hansimb/pedal-controller-prototype/docs/part2/setup.jpg

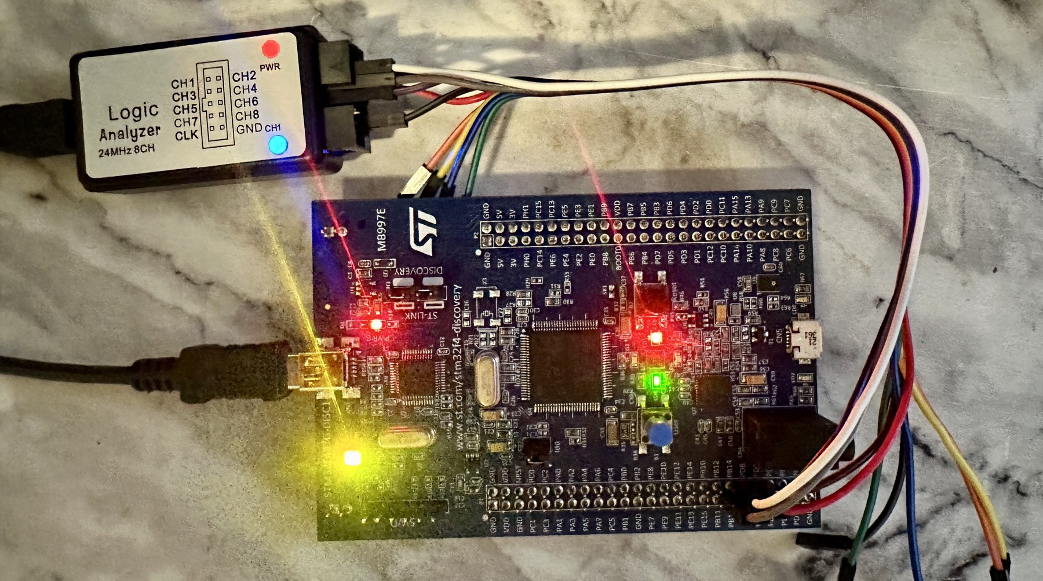
docs/part2/setup.jpg
