hansimb/pedal-controller-prototype/docs/part2/leds_p1.jpg

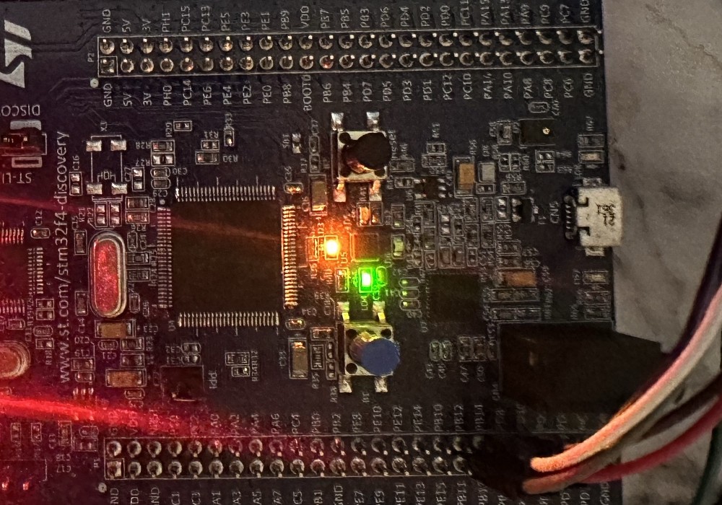
docs/part2/leds_p1.jpg
