hansimb/pedal-controller-prototype/docs/part2/leds_live.jpg

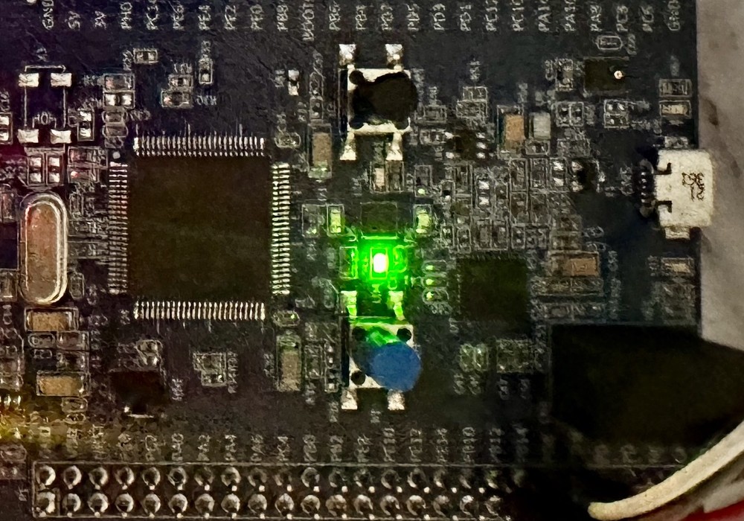
docs/part2/leds_live.jpg
