hansimb/pedal-controller-prototype/docs/part2/leds_p2.jpg

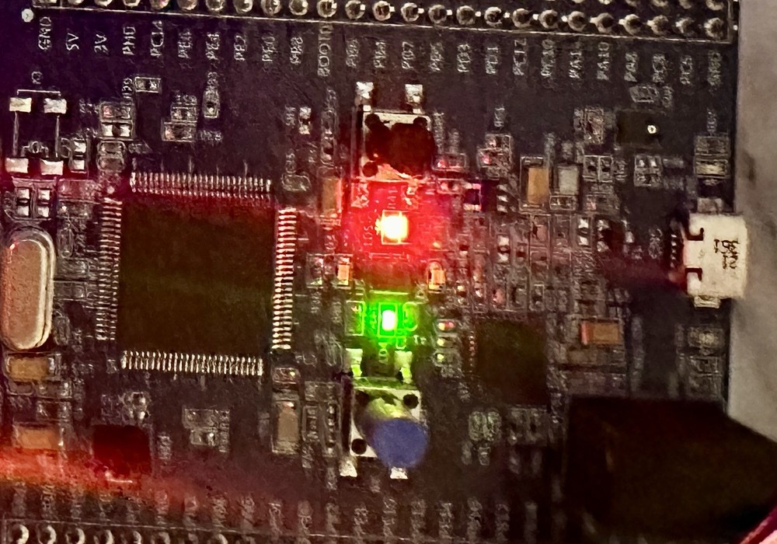
docs/part2/leds_p2.jpg
