hansimb/pedal-controller-prototype/docs/part2/leds_standby.jpg

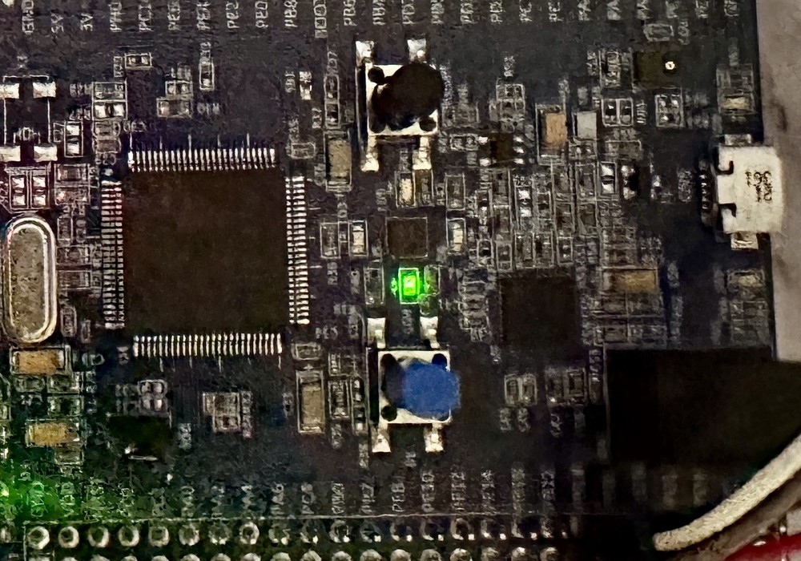
docs/part2/leds_standby.jpg
