hansimb/pedal-controller-prototype/docs/part2/spi_live.png

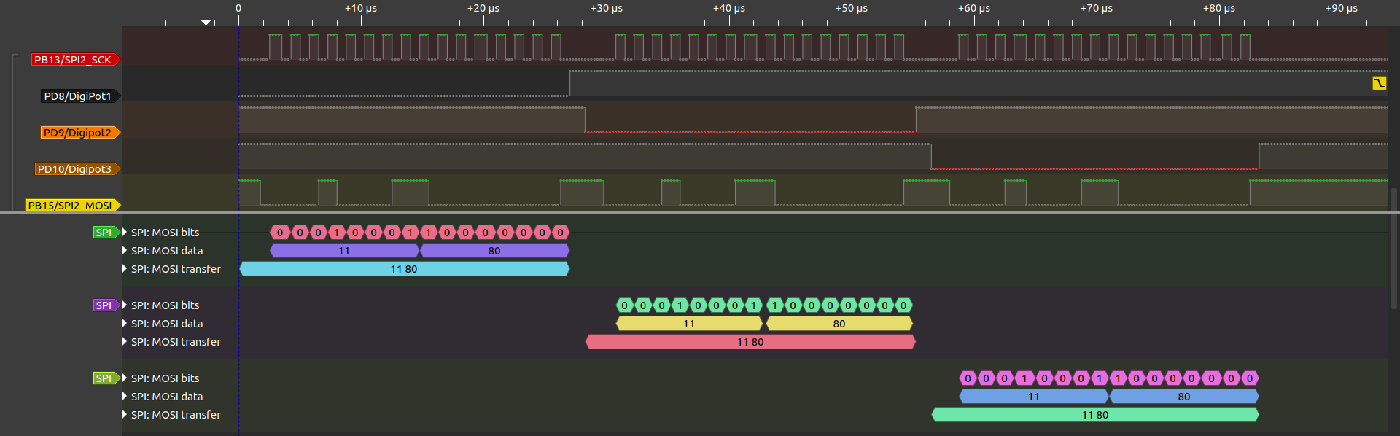
docs/part2/spi_live.png
