hansimb/pedal-controller-prototype/docs/part2/spi_p1.png

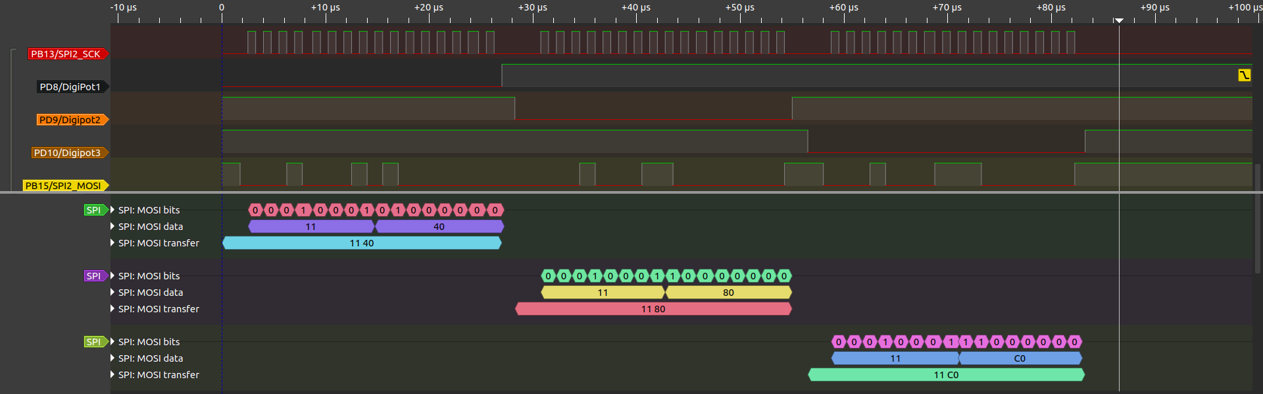
docs/part2/spi_p1.png
