hansimb/pedal-controller-prototype/docs/part2/spi_p2.png

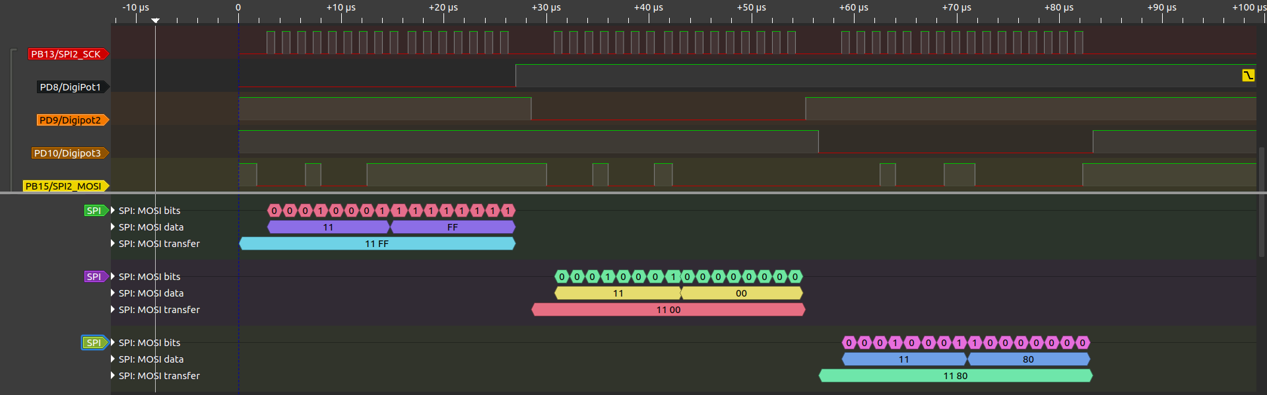
docs/part2/spi_p2.png
