hansimb/pedal-controller-prototype/docs/part2/spi_standby.png

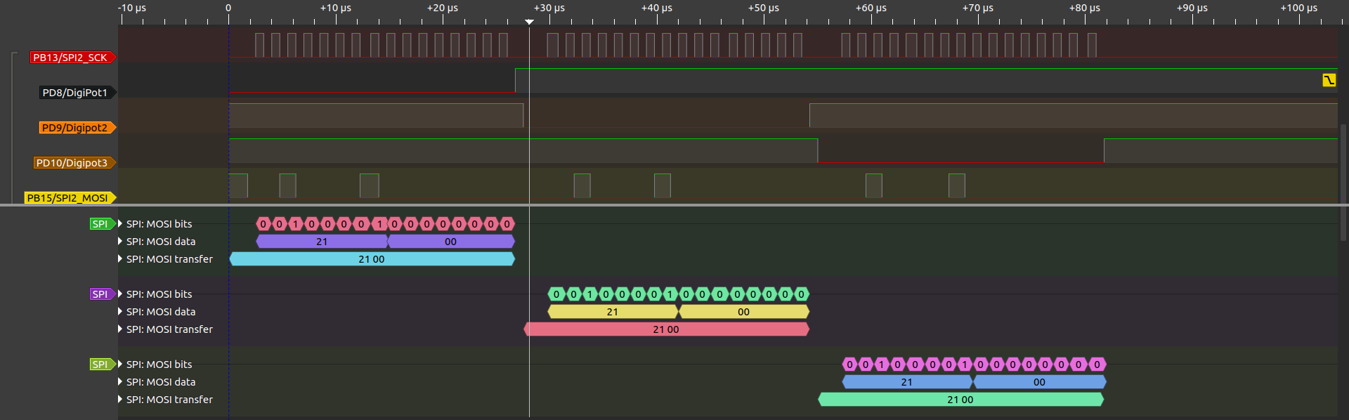
docs/part2/spi_standby.png
