hansimb/pedal-controller-prototype/docs/pedal_project_flow_chart.png

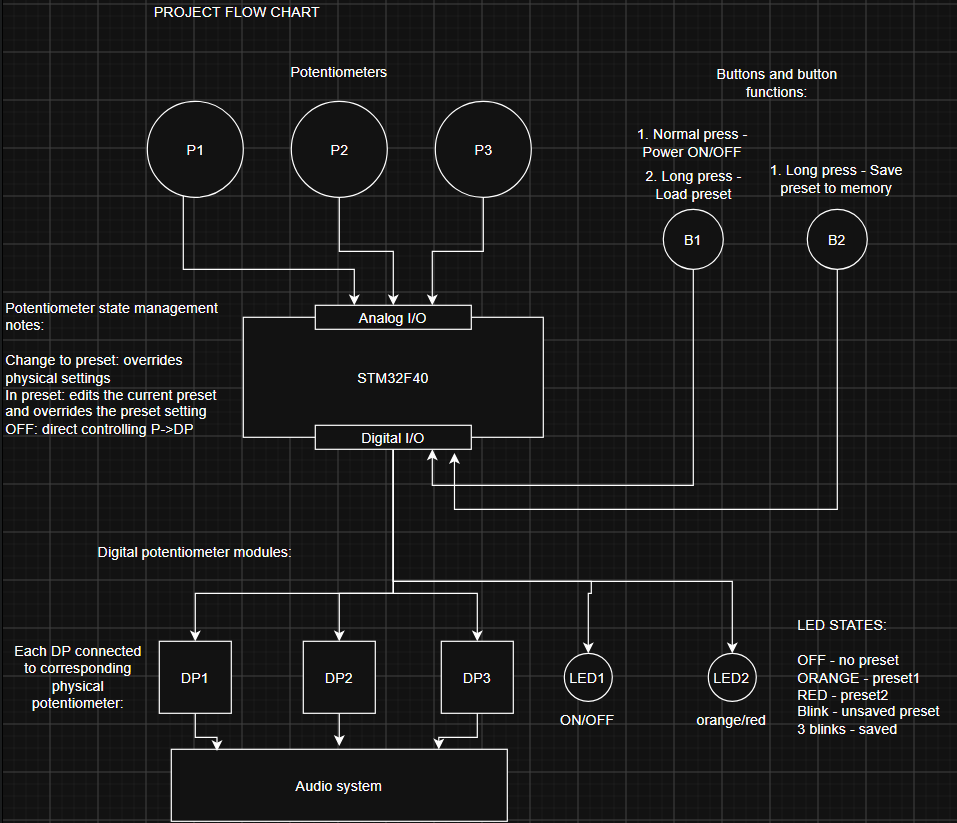
docs/pedal_project_flow_chart.png
