hansimb/pedal-controller-prototype/docs/peal-initial-plan-and-parts.png

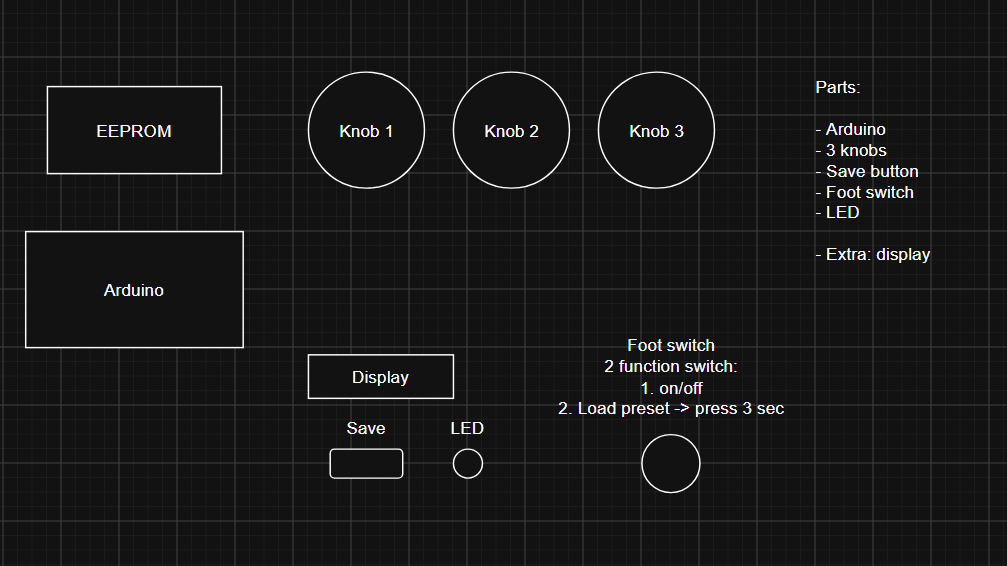
docs/peal-initial-plan-and-parts.png
