hansimb/pedal-controller-prototype/docs/AI-usage.md

- .gitignore contents for project src contents has been generated by AI to exclude buildfiles etc, what is not needed for version control
