hansimb/pedal-controller-prototype/pedal_controller/Core/Src/main.c

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
/* Includes ------------------------------------------------------------------*/
#include "main.h"
#include "usb_host.h"

/* USER CODE BEGIN Includes */
#include "demo.h"


/* USER CODE END Includes */

I2C_HandleTypeDef hi2c1;

I2S_HandleTypeDef hi2s3;

SPI_HandleTypeDef hspi1;
SPI_HandleTypeDef hspi2;

TIM_HandleTypeDef htim4;

void SystemClock_Config(void);
static void MX_GPIO_Init(void);
static void MX_I2C1_Init(void);
static void MX_I2S3_Init(void);
static void MX_SPI1_Init(void);
static void MX_SPI2_Init(void);
static void MX_TIM4_Init(void);
void MX_USB_HOST_Process(void);


/* USER CODE BEGIN 0 */

/*// wait ms milliseconds while the LED TIMING keeps running
static void wait(uint32_t ms)
{
	uint32_t t = HAL_GetTick();

	while (HAL_GetTick() - t < ms)
		leds_tick();
}*/

/* USER CODE END 0 */

/**
  * @brief  The application entry point.
  * @retval int
  */
int main(void)
{

  /* MCU Configuration--------------------------------------------------------*/

  /* Reset of all peripherals, Initializes the Flash interface and the Systick. */
  HAL_Init();

  /* Configure the system clock */
  SystemClock_Config();

  /* Initialize all configured peripherals */
  MX_GPIO_Init();
  MX_I2C1_Init();
  MX_I2S3_Init();
  MX_SPI1_Init();
  MX_USB_HOST_Init();
  MX_SPI2_Init();
  MX_TIM4_Init();

  /* USER CODE BEGIN 2 */
  // leds_init();
  // leds_set(PWR_ON, M_LIVE, 0);

  demo_init();


  /* USER CODE END 2 */

  /* Infinite loop */
  /* USER CODE BEGIN WHILE */
  while (1)
  {
    /* USER CODE END WHILE */
    MX_USB_HOST_Process();

    /* USER CODE BEGIN 3 */
/*
    // LED test: one state per second
    leds_set(PWR_ON, M_LIVE, 0);	// green only
    wait(1000);
    leds_set(PWR_ON, M_P1, 0);		// green + orange
    wait(1000);
    leds_set(PWR_ON, M_P2, 1);		// green + red + blue (edited)
    wait(1000);
    leds_saved();	// save: 3 fast blue blinks
    leds_set(PWR_ON, M_P2, 0);
    wait(1000);
    leds_set(PWR_DIM, M_P2, 0);		// standby: green dim, the rest off
    wait(1000);
  }


    ev_t ev = button_event();
    if (ev == EV_B1_SHORT) HAL_GPIO_TogglePin(LD3_GPIO_Port, LD3_Pin);
    if (ev == EV_B1_LONG) HAL_GPIO_TogglePin(LD5_GPIO_Port, LD5_Pin);

    */

    demo_tick();
  /* USER CODE END 3 */
}
}

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
