hansimb/pedal-controller-prototype/(commit log)

2026-09-17 Planning documents & flow chart
2026-09-17 Fix: LED connections added
2026-09-23 Change board to STM32F40 & audio system side
2026-09-23 fix: LED2 states
2026-09-23 fix: update flowchart .drawio
2026-10-26 firmware: CubeMX project with SPI2 digital pot driver
    STM32F407G-DISC1 project made with CubeMX in STM32CubeIDE 1.19.0. SPI2 transmit only, mode 0, 656.25 kHz: SCK on PB13, MOSI on PB15. Digital pot select pins PD8, PD9, PD10 (DigiPot1-3). digipot_set(ch, val) sends 0x11 and the value to one MCP41010. Checked with a logic analyzer.
    src/ has no .ioc or HAL, so the CubeMX project is in pedal_controller/. OK to remove src/ later?
2026-10-27 firmware: board LED driver with dimmed standby
    Main loop runs an LED test sequence for now.
2026-10-27 firmware: B1 button with debounce and short/long press
    PC0 set to Reset_State in CubeMX. CubeMX then removed usbh_platform.c and .h. USB is not used in this project.
2026-10-27 firmware: Part 2 demo loop with LED self-test
2026-10-28 Part 2 test: pulse analyzer captures and board photos
