hansimb/pedal-controller-prototype/(notices)

Notices in the files:
pedal_controller/Core/Src/main.c:
Copyright (c) 2026 STMicroelectronics.
All rights reserved.
This software is licensed under terms that can be found in the LICENSE file
